kendiser5000/Polaroid_Camera_with_Thermal_Printer_v1/README.md

# Camera-with-Thermal-Printer

Camera with Thermal Printer

Uses:
  -TM4C123/TM4c1294
  -TTL Serial Thermal Printer
  -VC0706 Camera
  -ESP8266 for WiFi
