kendiser5000/Polaroid_Camera_with_Thermal_Printer_v1/(list of files, drawings)

Other design files:
Pcb and Sch/UTX-2018121.pcb
Pcb and Sch/UTX-2018122.pcb
Pcb and Sch/~Lab7_TM4C123starter.pcb
