kendiser5000/Polaroid_Camera_with_Thermal_Printer_v1/Camera Drivers/FiFo.c

// FiFo.c
// Runs on LM4F120/TM4C123
// Provide functions that implement the Software FiFo Buffer
// Last Modified: 4/10/2017 
// Student names: change this to your names or look very silly
// Last modification date: change this to the last modification date or look very silly

#include <stdint.h>
#include "FiFo.h"
// --UUU-- Declare state variables for FiFo
//        size, buffer, put and get indexes

#define SIZE 4000
static uint16_t PutI  = 0;
static uint16_t GetI;
static uint8_t FIFO[SIZE];


// *********** FiFo_Init**********
// Initializes a software FIFO of a
// fixed size and sets up indexes for
// put and get operations

void FiFo_Init() {
	for (int i = 0; i < SIZE; i++){
		FIFO[i] = '\0';
	}
	PutI = GetI = 0;
}

// *********** FiFo_Put**********
// Adds an element to the FIFO
// Input: Character to be inserted
// Output: 1 for success and 0 for failure
//         failure is when the buffer is full
uint32_t FiFo_Put(char data) {
	// --UUU-- Complete this routine
	if (((PutI+1) % SIZE) == GetI){
		return 0;
	}
	FIFO[PutI] = data;
	PutI = (PutI + 1) % SIZE;
   return(1); //Replace this
}

// *********** FiFo_Get**********
// Gets an element from the FIFO
// Input: Pointer to a character that will get the character read from the buffer
// Output: 1 for success and 0 for failure
//         failure is when the buffer is empty
uint32_t FiFo_Get(char *datapt)
{
	if (GetI == PutI) {
          return(0);
   }
   *datapt = FIFO[GetI];
   GetI = (GetI + 1) % SIZE;
   return(1);
}
