kendiser5000/Polaroid_Camera_with_Thermal_Printer_v1/Camera Drivers/SD_LCD_BITMAP/Uart1.h

// UART.c
// Runs on LM4F120/TM4C123
// Provides Prototypes for functions implemented in UART.c
// Last Modified: 3/6/2015 
// Student names: change this to your names or look very silly
// Last modification date: change this to the last modification date or look very silly

#include <stdint.h>
#include "inc/tm4c123gh6pm.h"


// UART initialization function 
// Input: none
// Output: none
void UART1_Init(void);

//------------UART_InChar------------
// Wait for new input,
// then return ASCII code
// Input: none
// Output: char read from UART
// *** Need not be busy-wait if you know when to call
char UART1_InChar(void);

//------------UART_OutChar------------
// Wait for new input,
// then return ASCII code
// Input: none
// Output: char read from UART1
void UART1_OutChar(char data);

//------------UART_OutChar------------
// Wait for new input,
// then return ASCII code
// Input: none
// Output: char read from UART2
void UART1_OutChar(char data);
